DB0SL/vxr9000-tuercontroller/Schaltplan/db0slcontroller.sch

## EAGLE design Schaltplan/db0slcontroller.sch (2026-09-28)

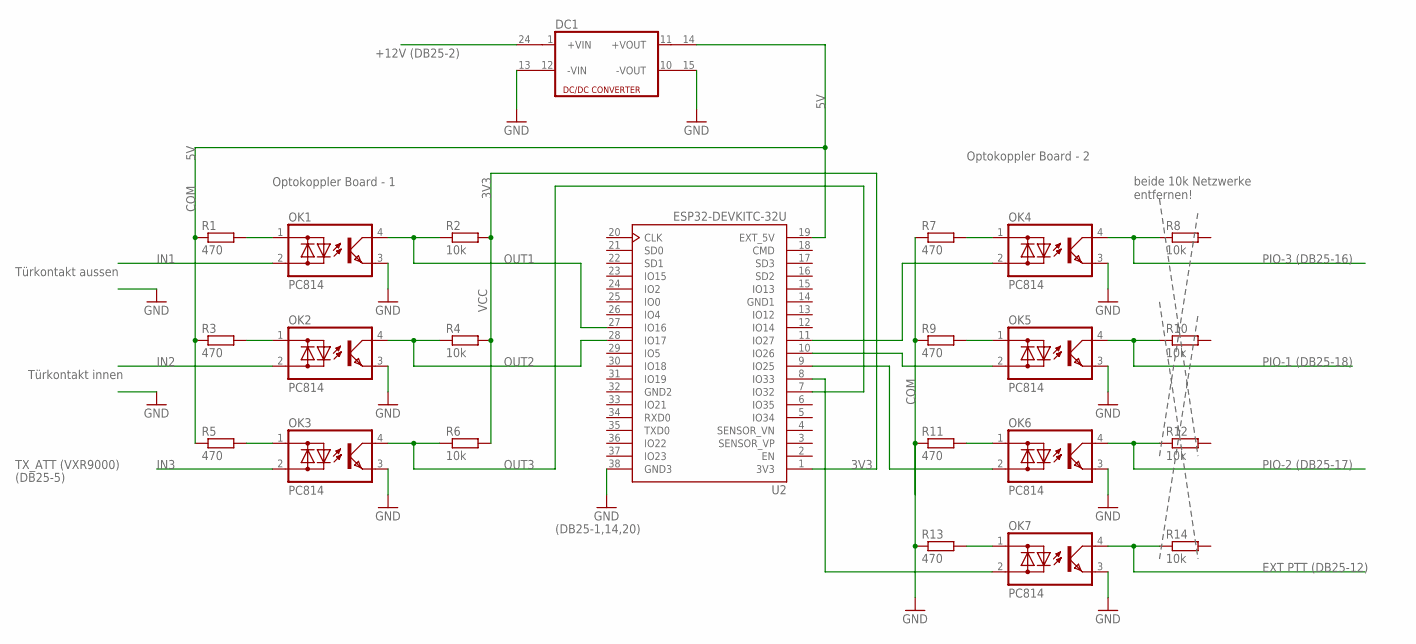
[picture p1: schematic db0slcontroller.sch]

Parts:
DC1: DC213R; CMK
OK1, OK2, OK3, OK4, OK5, OK6, OK7: PC814; DIL04
R1, R3, R5, R7, R9, R11, R13: 470; M0805
R2, R4, R6, R8, R10, R12, R14: 10k; M0805
U2: ESP32-DEVKITC-32U; MODULE_ESP32-DEVKITC-32U

Connections:
3V3: R2.2, R4.2, R6.2, U2.1 (3V3)
5V: DC1.14 (+VOUT1), R1.1, R3.1, R5.1, U2.19 (EXT_5V)
GND: DC1.13 (-VIN1), DC1.15 (-VOUT1), OK1.3 (E), OK2.3 (E), OK3.3 (E), OK4.3 (E), OK5.3 (E), OK6.3 (E), OK7.3 (E), R13.1, U2.38 (GND3)
IN1: OK1.2 (AC2)
IN2: OK2.2 (AC2)
IN3: OK3.2 (AC2)
IN4: OK4.2 (AC2), U2.11 (IO27)
IN5: OK5.2 (AC2), U2.10 (IO26)
IN6: OK6.2 (AC2), U2.9 (IO25)
IN7: OK7.2 (AC2), U2.8 (IO33)
unnamed: OK1.1 (AC1), R1.2
unnamed: OK2.1 (AC1), R3.2
unnamed: OK3.1 (AC1), R5.2
unnamed: OK4.1 (AC1), R7.2
unnamed: OK5.1 (AC1), R9.2
unnamed: OK6.1 (AC1), R11.2
unnamed: OK7.1 (AC1), R13.2
unnamed: R7.1, R9.1, R11.1
OUT1: OK1.4 (C), R2.1, U2.27 (IO16)
OUT2: OK2.4 (C), R4.1, U2.28 (IO17)
OUT3: OK3.4 (C), R6.1, U2.7 (IO32)
OUT4: OK4.4 (C), R8.1
OUT5: OK5.4 (C), R10.1
OUT6: OK6.4 (C), R12.1
OUT7: OK7.4 (C), R14.1

Notes on the sheet:
Türkontakt aussen
Türkontakt innen
COM
VCC
TX_ATT (VXR9000)
beide 10k Netzwerke entfernen!
PIO-3 (DB25-16)
PIO-1 (DB25-18)
PIO-2 (DB25-17)
(DB25-5)
(DB25-1,14,20)
Optokoppler Board - 1
Optokoppler Board - 2
+12V (DB25-2)
EXT PTT (DB25-12)
